renestraub/soundgun/production/soundgun.kicad_pcb

## KiCad design production/soundgun.kicad_pcb (2024-03-17)

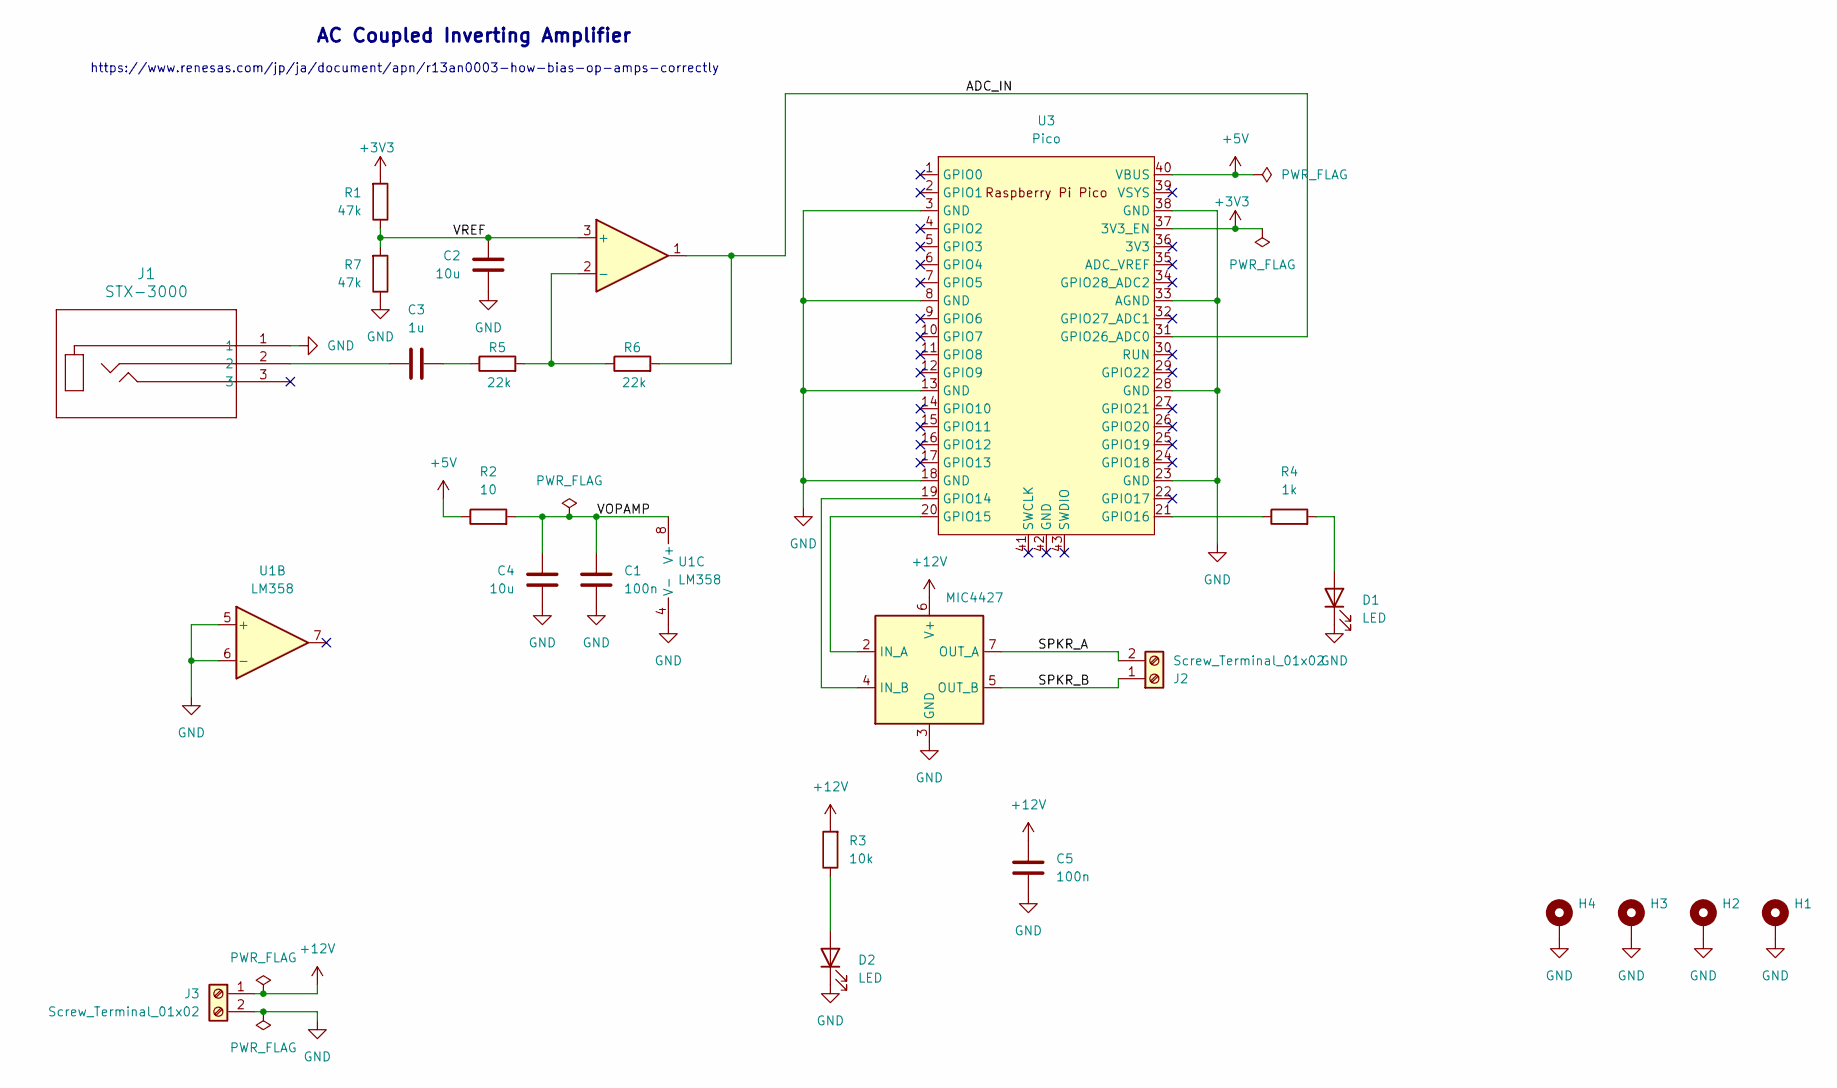
[picture p1: schematic soundgun.kicad_sch, Sound Gun]

Parts:
C1, C5: 100n; C_Disc_D3.8mm_W2.6mm_P2.50mm
C2, C4: 10u; C_Disc_D4.7mm_W2.5mm_P5.00mm
C3: 1u; C_Disc_D4.7mm_W2.5mm_P5.00mm
D1, D2: LED; LED_D5.0mm
H1, H2, H3, H4: MountingHole_Pad; MountingHole_3.2mm_M3_DIN965_Pad
J1: STX-3000; STX-3000_KYC
J2, J3: Screw_Terminal_01x02; TerminalBlock_Phoenix_PT-1,5-2-3.5-H_1x02_P3.50mm_Horizontal
R1, R7: 47k; R_Axial_DIN0204_L3.6mm_D1.6mm_P7.62mm_Horizontal
R2: 10; R_Axial_DIN0204_L3.6mm_D1.6mm_P7.62mm_Horizontal
R3: 10k; R_Axial_DIN0204_L3.6mm_D1.6mm_P7.62mm_Horizontal
R4: 1k; R_Axial_DIN0204_L3.6mm_D1.6mm_P7.62mm_Horizontal
R5, R6: 22k; R_Axial_DIN0204_L3.6mm_D1.6mm_P7.62mm_Horizontal
U1: LM358; DIP-8_W7.62mm_LongPads
U2: MIC4427; DIP-8_W7.62mm_LongPads
U3: Pico; RPi_Pico_SMD_TH

Connections:
+3V3: R1.2, U3.37 (3V3_EN)
+5V: R2.1, U3.40 (VBUS)
+12V: C5.2, J3.1, R3.2, U2.6 (V+)
/ADC_IN: R6.2, U1.1, U3.31 (GPIO26_ADC0)
/SPKR_A: J2.2, U2.7 (OUT_A)
/SPKR_B: J2.1, U2.5 (OUT_B)
/VOPAMP: C1.2, C4.2, R2.2, U1.8 (V+)
/VREF: C2.2, R1.1, R7.2, U1.3 (+)
GND: C1.1, C2.1, C4.1, C5.1, D1.1 (K), D2.1 (K), H1.1, H2.1, H3.1, H4.1, J1.1, J3.2, R7.1, U1.4 (V-), U1.5 (+), U1.6 (-), U2.3 (GND), U3.3 (GND), U3.8 (GND), U3.13 (GND), U3.18 (GND), U3.23 (GND), U3.28 (GND), U3.33 (AGND), U3.38 (GND)
unnamed: C3.1, J1.2
unnamed: C3.2, R5.1
unnamed: D1.2 (A), R4.2
unnamed: D2.2 (A), R3.1
unnamed: R5.2, R6.1, U1.2 (-)
unnamed: U2.2 (IN_A), U3.20 (GPIO15)
unnamed: U2.4 (IN_B), U3.19 (GPIO14)
unnamed: R4.1, U3.21 (GPIO16)

Notes on the sheet:
https://www.renesas.com/jp/ja/document/apn/r13an0003-how-bias-op-amps-correctly
AC Coupled Inverting Amplifier

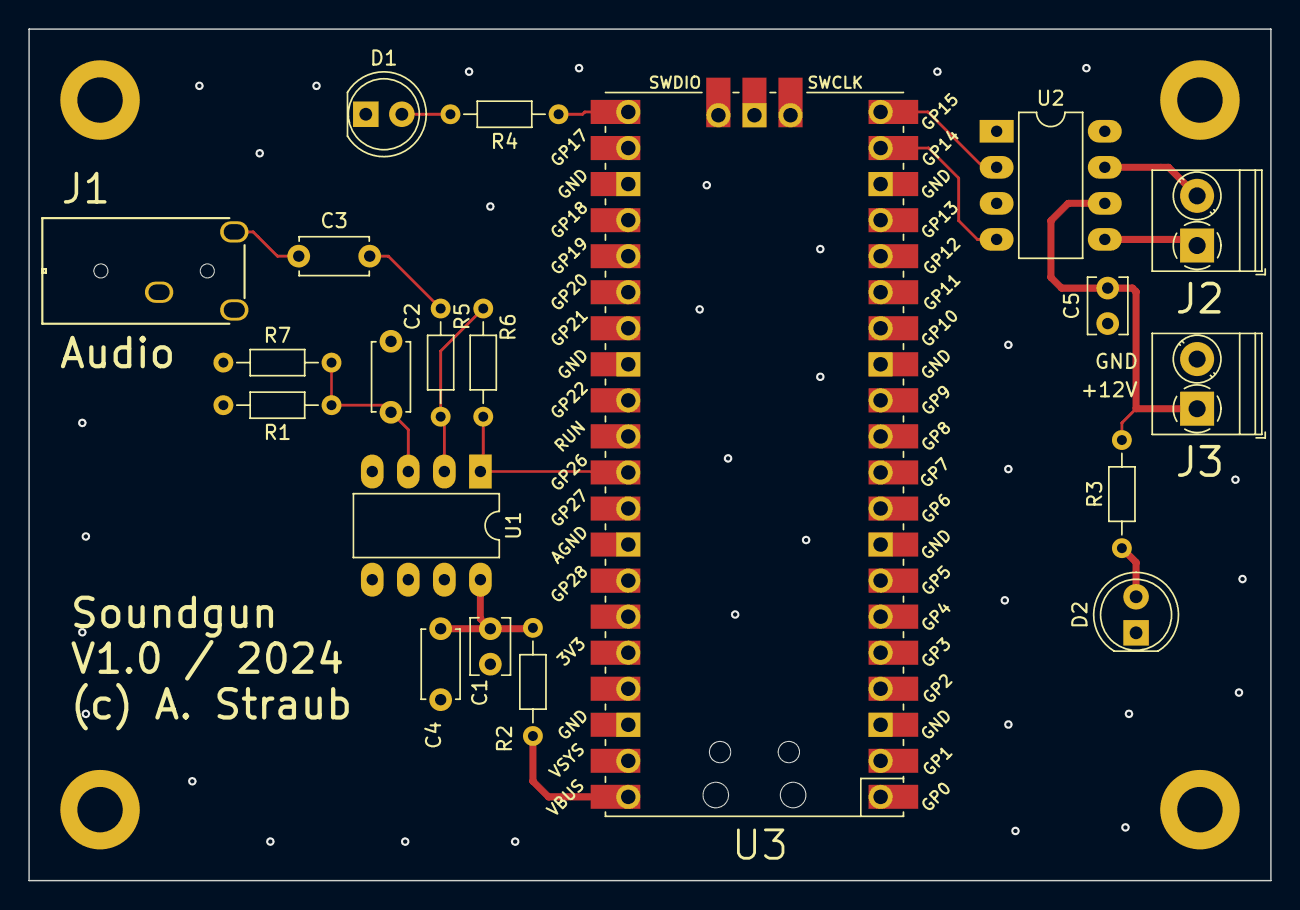
[picture p2: board soundgun.kicad_pcb from above]

Board: 4 copper layers, 87.5 x 60.0 mm, 24 parts (0 on the bottom side), 17 nets.
