renestraub/soundgun/(commit log)

2024-03-10 Rearranged files
    [soundgun.kicad_pcb, soundgun.kicad_sch]
2024-03-10 Cleaned Release project
    [soundgun.kicad_pcb, soundgun.kicad_sch]
2024-03-10 Added model paths
    [soundgun.kicad_pcb, soundgun.kicad_sch]
2024-03-17 Created production PCB
    [soundgun.kicad_pcb, soundgun.kicad_sch]
2024-03-17 Created production data
    [soundgun-B_Cu.gbl, soundgun-B_Mask.gbs, soundgun-B_Paste.gbp, soundgun-B_Silkscreen.gbo, soundgun-Edge_Cuts.gm1, soundgun-F_Cu.gtl, soundgun-F_Mask.gts, soundgun-F_Paste.gtp]
2024-04-11 Added original schematics image
2024-04-16 Major refactoring
    - 40 kHz sampling rate, 12 bit samples
    - Machine code optimized
    - General cleanup
2024-05-20 First release
    - Add LED toggling
    - Standalone run
